bao-eng/kicad-lib/README.md

# kicad-lib
https://klc.kicad.org/

## 3D models paths
3D models paths are relative to the ```KICAD_BAO_LIB```. \
Got to ```Prefrences>Configure paths```. \
Create ```KICAD_BAO_LIB``` environment variable and assign path to the cloned repo.
